ManDon5/Lotus-HomeKit-Monitoring/(notices)

Notices in the files:
docs/README.md:
License: MIT
